IIAx0II/Motor-Controller-SEMA-2020/bldc-hardware-master/design/PNGs/F_Modules-1.png

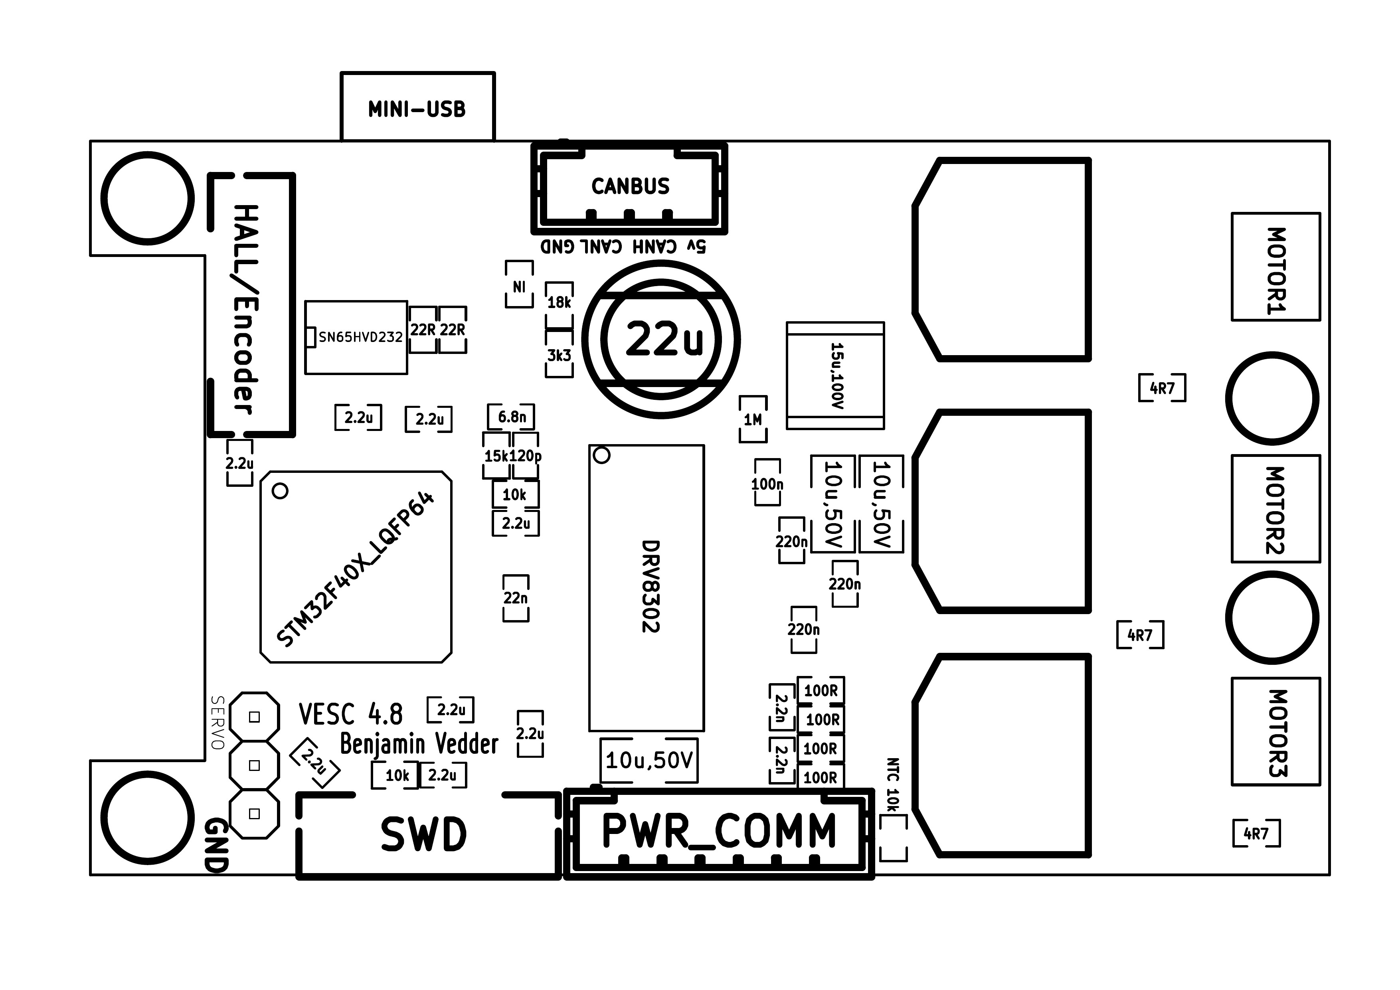
bldc-hardware-master/design/PNGs/F_Modules-1.png
