IIAx0II/Motor-Controller-SEMA-2020/bldc-hardware-master/design/PNGs/Schematic-5.png

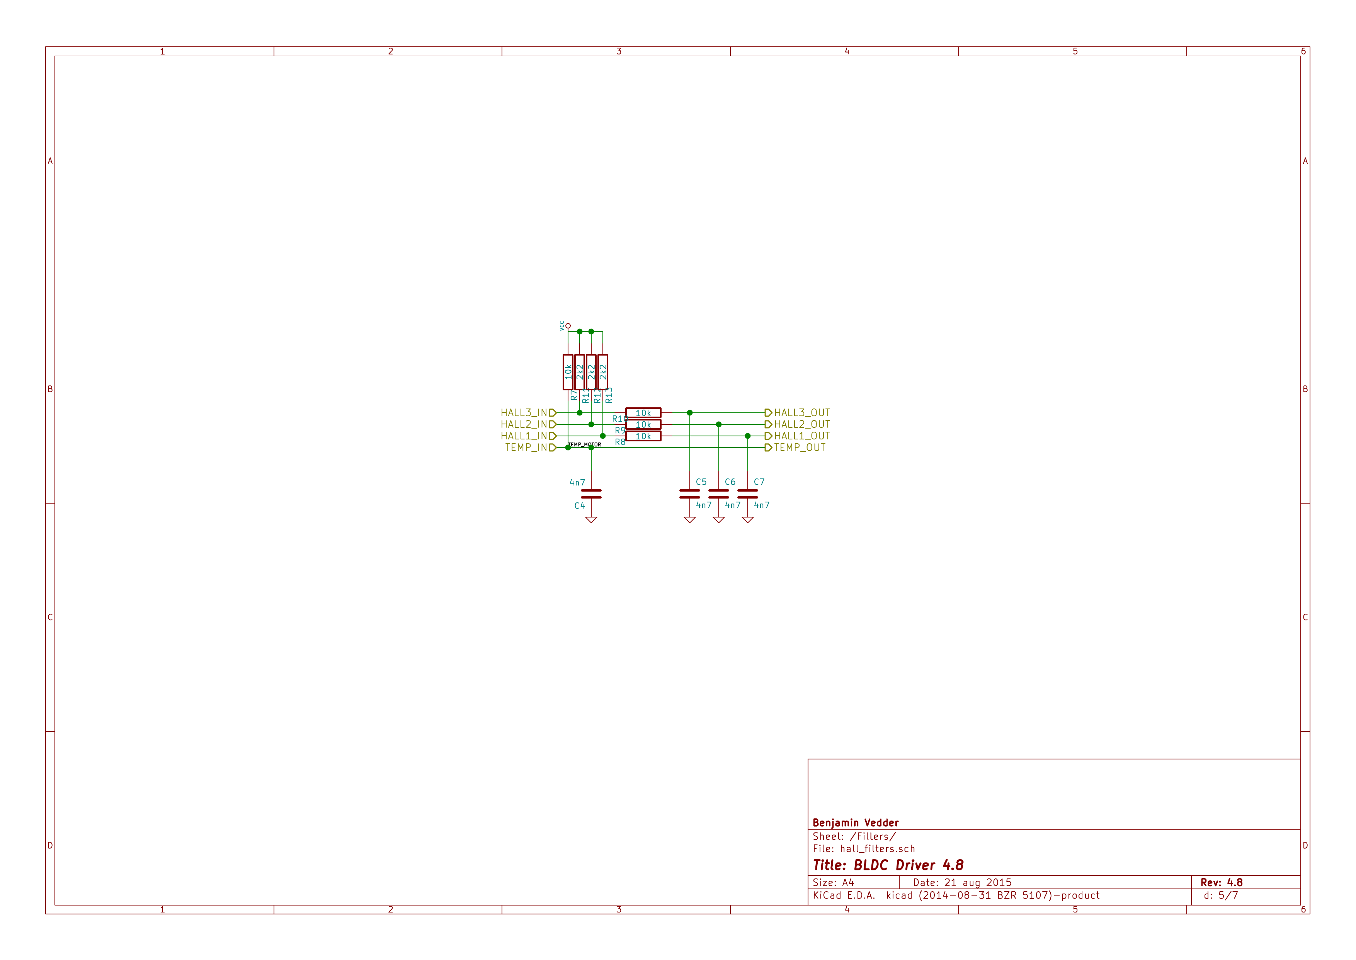
bldc-hardware-master/design/PNGs/Schematic-5.png
