IIAx0II/Motor-Controller-SEMA-2020/bldc-hardware-master/design/PNGs/vesc_back_silk_neg.png

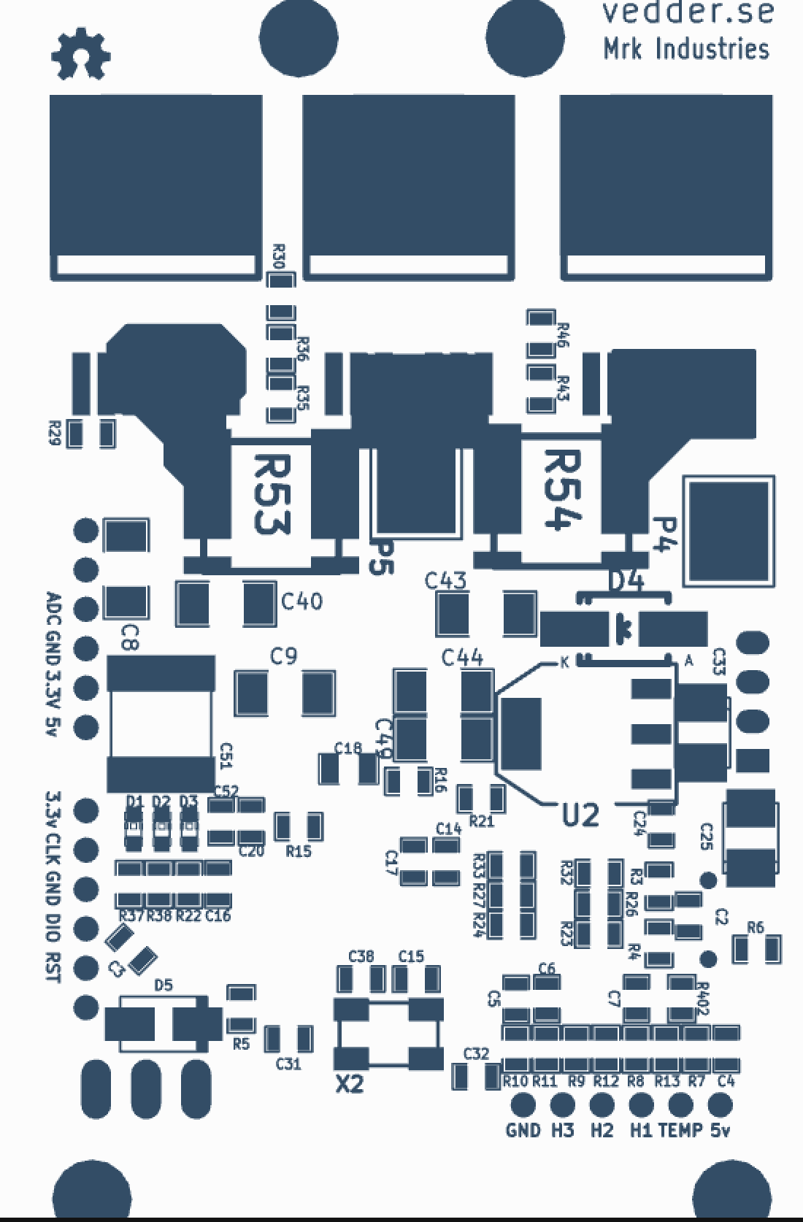
bldc-hardware-master/design/PNGs/vesc_back_silk_neg.png
