IIAx0II/Motor-Controller-SEMA-2020/(commit log)

2020-02-16 Commit #1
    [BLDC4.12_BOM.ods, BLDC_4-2020-02-10-16-07-24.sch, BLDC_4-2020-02-15-08-23-24.sch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]
2020-02-16 generated cam files
    [BLDC_4-B_Cu.gbl, BLDC_4-B_Mask.gbs, BLDC_4-B_Paste.gbp, BLDC_4-B_SilkS.gbo, BLDC_4-Edge_Cuts.gm1, BLDC_4-F_Cu.gtl, BLDC_4-F_Mask.gts, BLDC_4-F_Paste.gtp]
